obdevel/CBUS-MP3-Player/Hardware/CANMP3_rev6_brd.pdf

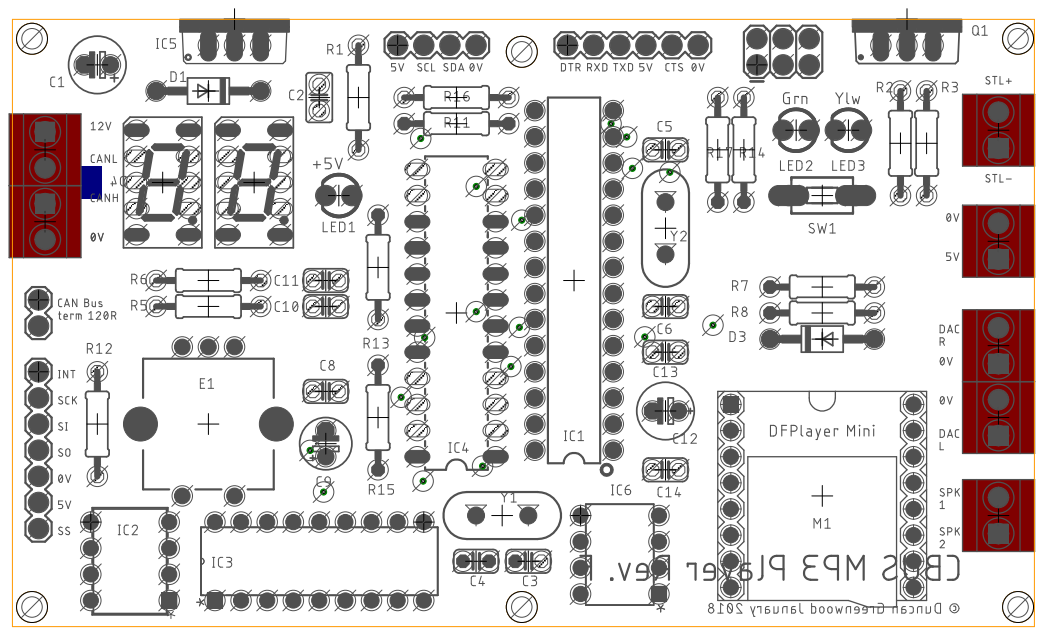
[picture p3: page 1]
