obdevel/CBUS-MP3-Player/Hardware/CANMP3_rev6_layout.pdf

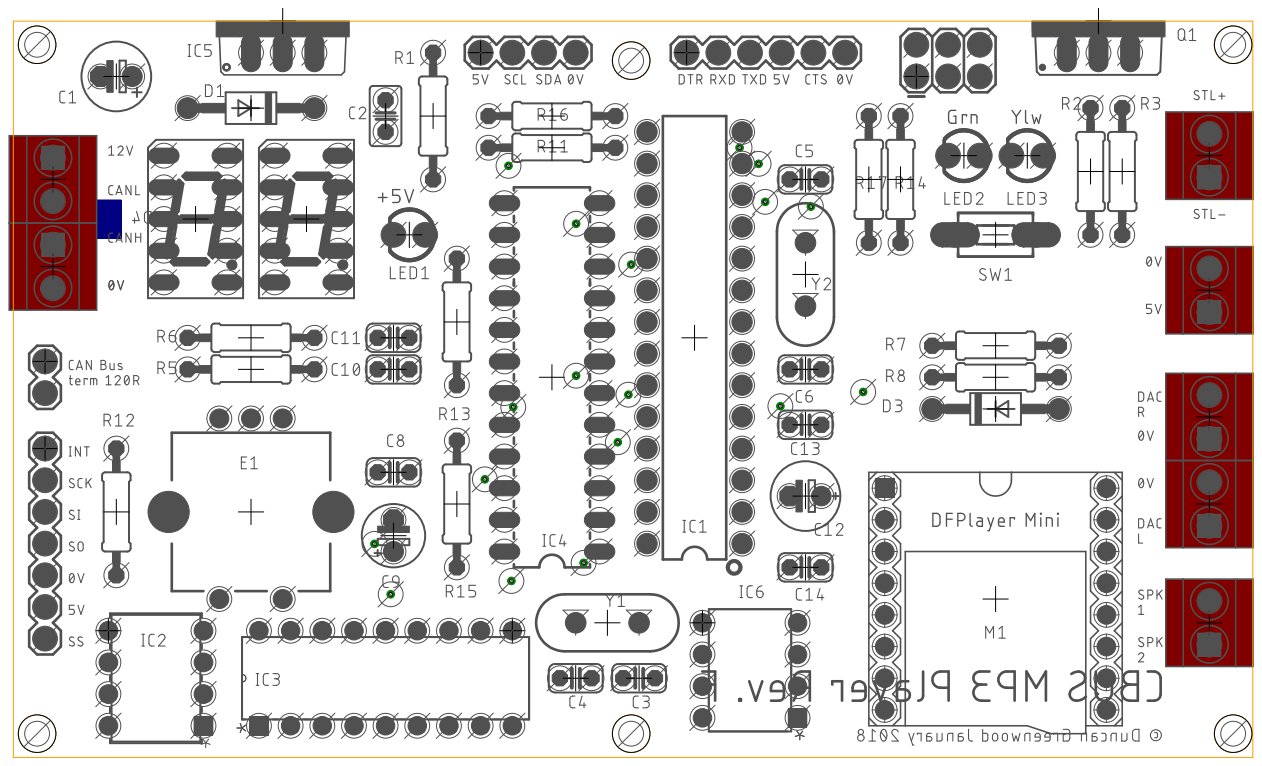
[picture p4: page 1]
