obdevel/CBUS-MP3-Player/Hardware/CANMP3_rev6_sch.pdf

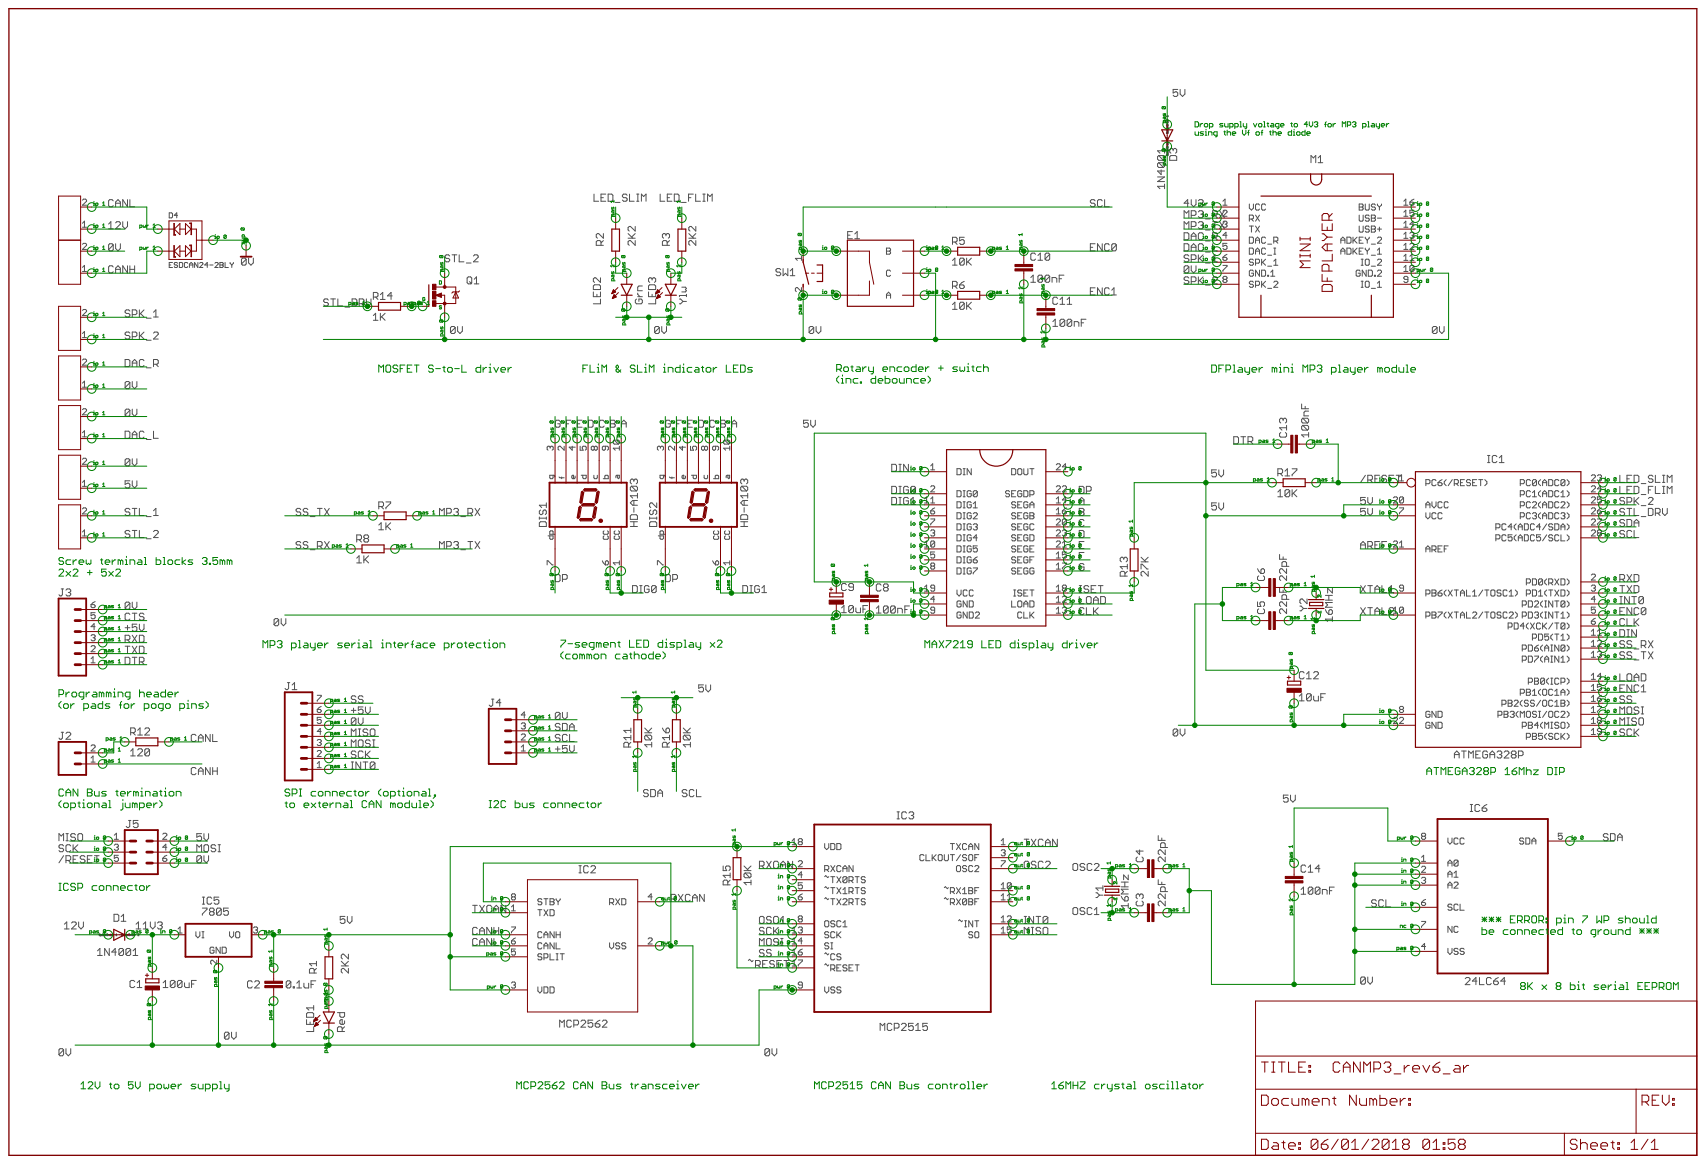
[picture p5: page 1]
