obdevel/CBUS-MP3-Player/Hardware/CANMP3_rev6_ar.brd

## EAGLE design Hardware/CANMP3_rev6_ar.brd (2018-06-25)

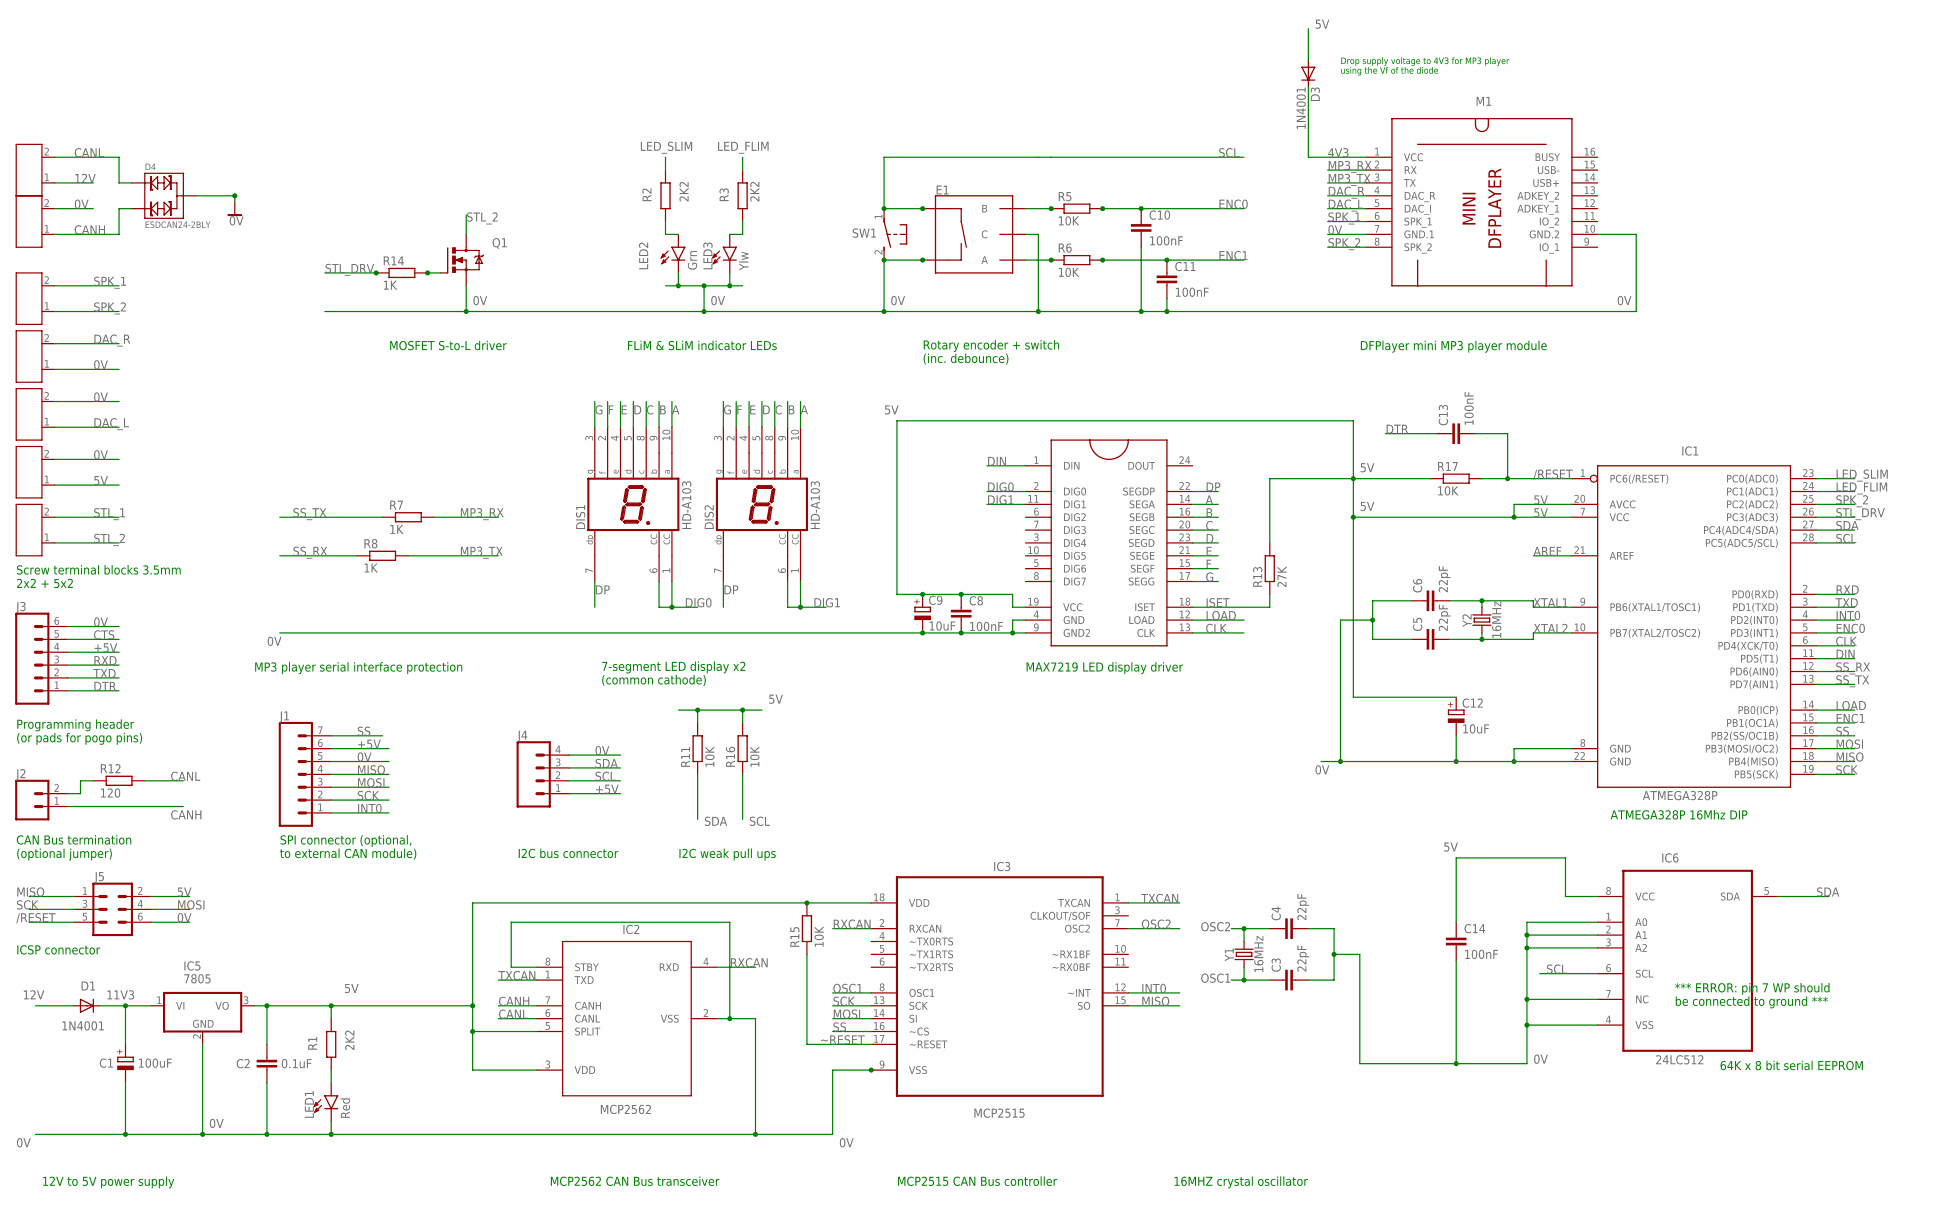
[picture p6: schematic CANMP3_rev6_ar.sch]

Parts:
C1: 100uF; E2,5-6
C2: 0.1uF; C025-025X050
C3, C4, C5, C6: 22pF; C025-024X044
C8, C10, C11, C13, C14: 100nF; C025-024X044
C9: 10uF; E2,5-5
C12: 10uF; E2,5-6E
D1, D3: 1N4001; DO41-10
D4: ESDCAN24-2BLY; SOT-23
DIS1, DIS2: HD-A103; HDSP-A
E1: ENCODER-SWITCH; ROTARY_ENC_PLAIN
IC1: ATMEGA328P; DIP28
IC2: MCP2562; PDIP8_300MC
IC3: MCP2515; DIP254P762X432-18
IC4: MAX7219; DIL24
IC5: 7805; TO220V
IC6: 24LC512; DIP254P762X432-8
J1: CONN_07; 1X07
J2: CONN_02; 1X02
J3: CONN_06SILK_FEMALE_PTH; 1X06
J4: CONN_04; 1X04
J5: FEMALE 2x3; 2X3
LED1: Red; LED_3MM
LED2: Grn; LED_3MM
LED3: Ylw; LED_3MM
M1: DFPLAYER-MINI-MODULE
Q1: IRF540; TO220BV
R1, R2, R3: 2K2; 0207/10
R5, R6, R11, R15, R16, R17: 10K; 0207/10
R7, R8, R14: 1K; 0207/10
R12: 120; 0207/10
R13: 27K; 0207/10
SW1: DTS-3
TB1, TB2, TB3, TB4, TB5, TB6, TB7: SCREW-TERMINAL-GREEN(2P-3.5); H2-3.5-7.0X7.0MM
Y1, Y2: 16MHz; HC49US

Connections:
0V: C1.-, C2.2, C3.2, C4.2, C5.1, C6.1, C8.2, C9.-, C10.2, C11.2, C12.-, C14.2, D4.3, E1.C, E1.SW-, IC1.8 (GND), IC1.22 (GND), IC2.2 (VSS), IC2.8 (STBY), IC3.9 (VSS), IC4.4 (GND), IC4.9 (GND2), IC5.2 (GND), IC6.1 (A0), IC6.2 (A1), IC6.3 (A2), IC6.4 (VSS), IC6.7 (NC), J1.5, J3.6, J4.4, J5.6, LED1.K (C), LED2.K (C), LED3.K (C), M1.7 (GND.1), M1.10 (GND.2), Q1.S, SW1.2, TB2.2, TB4.2, TB5.2, TB6.1
4V3: D3.C, M1.1 (VCC)
5V: C2.1, C8.1, C9.+, C12.+, C14.1, D3.A, IC1.7 (VCC), IC1.20 (AVCC), IC2.3 (VDD), IC2.5 (SPLIT), IC3.18 (VDD), IC4.19 (VCC), IC5.3 (VO), IC6.8 (VCC), J5.2, R1.2, R11.2, R13.2, R15.2, R16.2, R17.1, TB5.1
11V3: C1.+, D1.C, IC5.1 (VI)
12V: D1.A, TB1.1
+5V: J1.6, J3.4, J4.1
/RESET: C13.2, IC1.1 (PC6(/RESET)), J5.5, R17.2
A: DIS1.10 (A), DIS2.10 (A), IC4.14 (SEGA)
AREF: IC1.21 (AREF)
B: DIS1.9 (B), DIS2.9 (B), IC4.16 (SEGB)
C: DIS1.8 (C), DIS2.8 (C), IC4.20 (SEGC)
CANH: D4.2, IC2.7 (CANH), J2.1, TB2.1
CANL: D4.1, IC2.6 (CANL), R12.2, TB1.2
CLK: IC1.6 (PD4(XCK/T0)), IC4.13 (CLK)
CTS: J3.5
D: DIS1.5 (D), DIS2.5 (D), IC4.23 (SEGD)
DAC_L: M1.5 (DAC_I), TB4.1
DAC_R: M1.4 (DAC_R), TB6.2
DIG0: DIS1.1 (CC), DIS1.6 (CC), IC4.2 (DIG0)
DIG1: DIS2.1 (CC), DIS2.6 (CC), IC4.11 (DIG1)
DIN: IC1.11 (PD5(T1)), IC4.1 (DIN)
DP: DIS1.7 (DP), DIS2.7 (DP), IC4.22 (SEGDP)
DTR: C13.1, J3.1
E: DIS1.4 (E), DIS2.4 (E), IC4.21 (SEGE)
ENC0: C10.1, IC1.5 (PD3(INT1)), R5.2
ENC1: C11.1, IC1.15 (PB1(OC1A)), R6.2
F: DIS1.2 (F), DIS2.2 (F), IC4.15 (SEGF)
G: DIS1.3 (G), DIS2.3 (G), IC4.17 (SEGG)
INT0: IC1.4 (PD2(INT0)), IC3.12 (~INT), J1.1
ISET: IC4.18 (ISET), R13.1
LED_FLIM: IC1.24 (PC1(ADC1)), R3.2
LED_SLIM: IC1.23 (PC0(ADC0)), R2.2
LOAD: IC1.14 (PB0(ICP)), IC4.12 (LOAD)
MISO: IC1.18 (PB4(MISO)), IC3.15 (SO), J1.4, J5.1
MOSI: IC1.17 (PB3(MOSI/OC2)), IC3.14 (SI), J1.3, J5.4
MP3_RX: M1.2 (RX), R7.2
MP3_TX: M1.3 (TX), R8.2
unnamed: LED1.A, R1.1
unnamed: J2.2, R12.1
unnamed: E1.B, R5.1
unnamed: E1.A, R6.1
unnamed: LED2.A, R2.1
unnamed: LED3.A, R3.1
unnamed: Q1.G, R14.2
OSC1: C3.1, IC3.8 (OSC1), Y1.1
OSC2: C4.1, IC3.7 (OSC2), Y1.2
RXCAN: IC2.4 (RXD), IC3.2 (RXCAN)
RXD: IC1.2 (PD0(RXD)), J3.3
SCK: IC1.19 (PB5(SCK)), IC3.13 (SCK), J1.2, J5.3
SCL: E1.SW+, IC1.28 (PC5(ADC5/SCL)), IC6.6 (SCL), J4.2, R16.1, SW1.1
SDA: IC1.27 (PC4(ADC4/SDA)), IC6.5 (SDA), J4.3, R11.1
SPK_1: M1.6 (SPK_1), TB3.2
SPK_2: IC1.25 (PC2(ADC2)), M1.8 (SPK_2), TB3.1
SS: IC1.16 (PB2(SS/OC1B)), IC3.16 (~CS), J1.7
SS_RX: IC1.12 (PD6(AIN0)), R8.1
SS_TX: IC1.13 (PD7(AIN1)), R7.1
STL_1: TB7.2
STL_2: Q1.D, TB7.1
STL_DRV: IC1.26 (PC3(ADC3)), R14.1
TXCAN: IC2.1 (TXD), IC3.1 (TXCAN)
TXD: IC1.3 (PD1(TXD)), J3.2
XTAL1: C6.2, IC1.9 (PB6(XTAL1/TOSC1)), Y2.2
XTAL2: C5.2, IC1.10 (PB7(XTAL2/TOSC2)), Y2.1
~RESET: IC3.17 (~RESET), R15.1

Notes on the sheet:
MAX7219 LED display driver
MCP2562 CAN Bus transceiver
12V to 5V power supply
MCP2515 CAN Bus controller
MOSFET S-to-L driver
DFPlayer mini MP3 player module
Rotary encoder + switch (inc. debounce)
MP3 player serial interface protection
Screw terminal blocks 3.5mm 2x2 + 5x2
CAN Bus termination (optional jumper)
FLiM & SLiM indicator LEDs
7-segment LED display x2 (common cathode)
16MHZ crystal oscillator
SPI connector (optional, to external CAN module)
Programming header (or pads for pogo pins)
ATMEGA328P 16Mhz DIP
Drop supply voltage to 4V3 for MP3 player using the Vf of the diode
64K x 8 bit serial EEPROM
I2C bus connector
ICSP connector
*** ERROR: pin 7 WP should be connected to ground ***
I2C weak pull ups

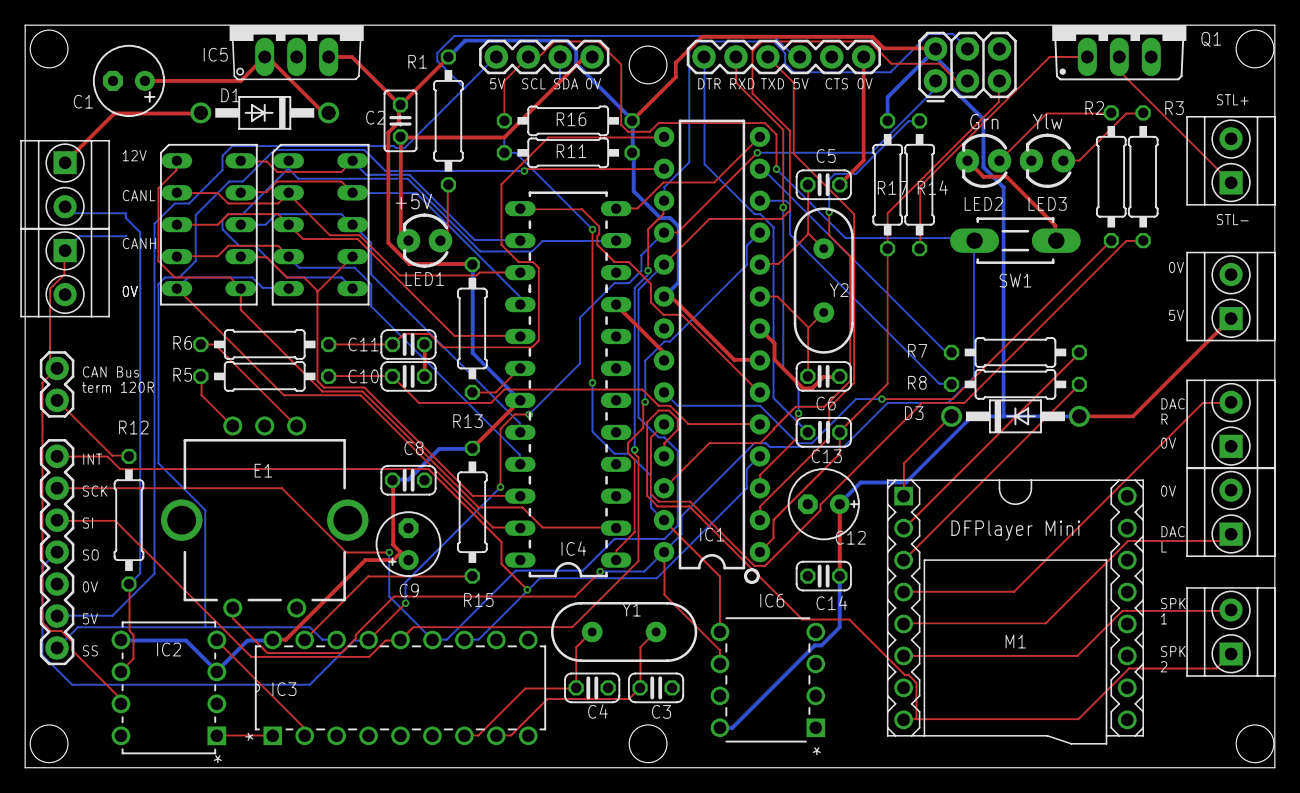
[picture p7: board CANMP3_rev6_ar.brd from above]

Board: 2 copper layers, 99.4 x 59.0 mm, 59 parts (1 on the bottom side), 61 nets.
