obdevel/CBUS-MP3-Player/(notices)

Notices in the files:
Hardware/CANMP3_rev6_ar.brd:
© Duncan Greenwood January 2018
parts and their libraries:
SparkFun-LED: Licensing: Creative Commons ShareAlike 4.0 International - https://creativecommons.org/licenses/by-sa/4.0
diy-modules: Released under the Creative Commons Attribution 4.0 International License: http://creativecommons.org/licenses/by/4.0
